Electric-Brain/Smart-Classroom-Automation/Images of Project/IMG4.jpeg

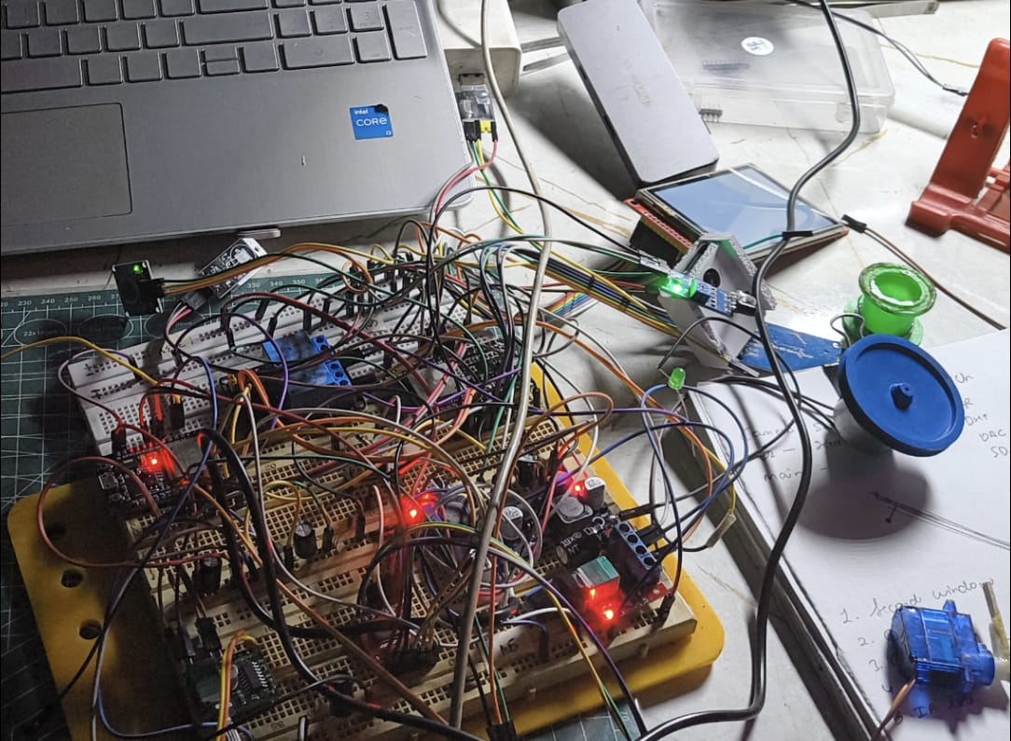
Images of Project/IMG4.jpeg
