Electric-Brain/Smart-Classroom-Automation/Images of Project/IMG1.jpeg

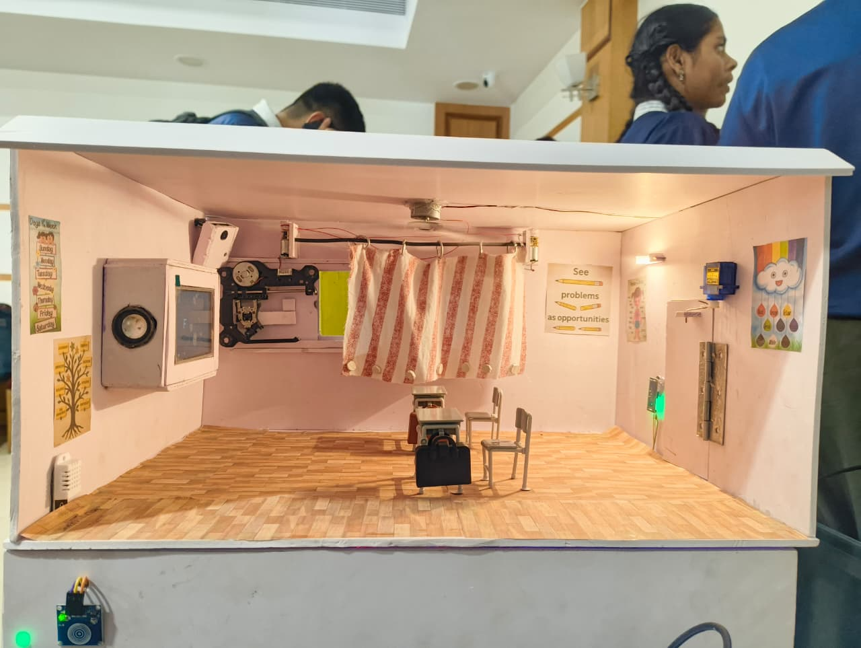
Images of Project/IMG1.jpeg
