Electric-Brain/Smart-Classroom-Automation/Documentation PDF/Autovent_SmartClassroom_Documentation (1).pdf

# AUTOVENT

# A Complete Smart Classroom

IoT-Based Classroom Automation System

Best Depth of Understanding Award — Yashwantrao Chavan Center, Mumbai

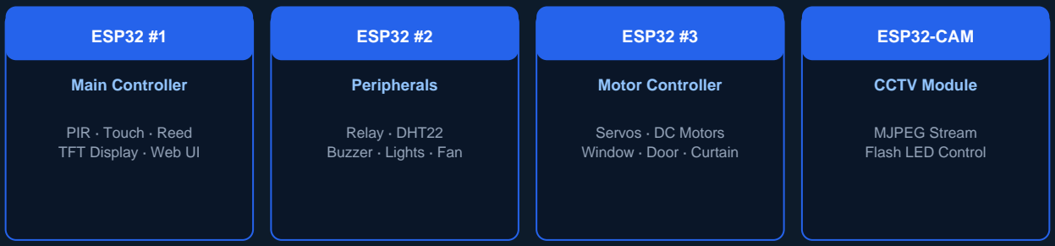
[picture p3: figure]
ESP32 #1; Main Controller; PIR · Touch · Reed TFT Display · Web UI; ESP32 #2; Peripherals; Relay · DHT22 Buzzer · Lights · Fan; ESP32 #3; Motor Controller; Servos · DC Motors Window · Door · Curtain; ESP32-CAM; CCTV Module; MJPEG Stream Flash LED Control

Institution | Thakur College of Engineering & Technology (TCET), Mumbai
Program | TCET Inhouse Internship
Collaboration | Agastya International Foundation
Deployed at | Sanmitra Mandal Vidhyalaya, Goregaon East
Team | Gautam | | Shivangi Vishwakarma
3× ESP32 · ESP32-CAM · | TFT Display | · Servo & DC Motors · WebSocket Dashboard

Technical Documentation — All Rights Reserved

Autovent — Smart Classroom | Technical Documentation

# Table of Contents

1. | Project Overview | 3
2. | System Architecture | 4
3. | Hardware Components — All Boards | 5
4. | Pin Mapping — All Boards | 7
5. | Firmware Modules | 10
6. | UART Communication Protocol | 13
7. | Web Dashboard | 14
8. | Setup & Flashing | 15
9. | Libraries Required | 16
10. | Known Issues & Fixes Applied | 17

# 1. Project Overview

Autovent is a fully integrated IoT-based smart classroom automation system developed as part of the TCET Inhouse Internship program in collaboration with the Agastya International Foundation. It was deployed and demonstrated at Sanmitra Mandal Vidhyalaya, Goregaon East, Mumbai, and received the Best Depth of Understanding Award at the project showcase held at Yashwantrao Chavan Center.

The concept was originated by school students who identified a real operational problem: the school peon was manually responsible for opening and closing windows, curtains, and doors multiple times every school day. Autovent automates this entirely through sensors, microcontrollers, motors, and a real-time web dashboard accessible from any browser on the local network.

## 1.1 Core Capabilities

- Automated door control via PIR motion detection with 5-second auto-close timer
- Motor-controlled Window 1, Window 2, Curtain, and Door (servo + DC motors)
- Relay-controlled classroom lights and ceiling fan with PWM fan speed control
- Live MJPEG video surveillance stream from the ESP32-CAM module
- Real-time temperature and humidity monitoring via DHT22 sensor
- Audio announcements via DFPlayer Mini + 3W speaker on ESP32 #2
- Reed switch close-confirmation with stuck-window detection and alert
- Full web dashboard with WebSocket-based live state synchronisation
- ILI9488 TFT status display showing sensor readings, actuator states, and WiFi info
- Capacitive touch sensor for physical master ON / OFF toggle
- Master switch: single action activates or fully deactivates the entire classroom
- Dual LM2596 buck converters step 12V down for logic and motor supply

## 1.2 Project Metadata

Field | Details
Institution | Thakur College of Engineering and Technology (TCET), Mumbai
Program | TCET Inhouse Internship
Collaboration | Agastya International Foundation
Deployed at | Sanmitra Mandal Vidhyalaya, Goregaon East, Mumbai
Award | Best Depth of Understanding — Yashwantrao Chavan Center Showcase
Team | Gautam, Shivangi Vishwakarma

# 2. System Architecture

The system uses four independent hardware nodes — three ESP32 boards and one ESP32-CAM — communicating over WiFi and UART. ESP32 #1 (Main Controller) acts as the central intelligence: it hosts the web server, processes all sensor inputs (PIR, touch, reed switches), drives the TFT display, and sends commands to both ESP32 #2 and ESP32 #3 over UART. ESP32 #2 handles all electrical peripherals (relays, buzzer, DHT22). ESP32 #3 is a dedicated motor controller. The ESP32-CAM operates fully independently on the WiFi network.

Board | Role | Peripherals | Communi cation
ESP32 #1 Main Controller | Central hub — web server, sensor processing, TFT display | TFT Display (ILI9488), PIR (HC-SR501), Touch (TTP223), Reed Switches ×2 | WiFi: HTTP + W ebSocket UART2 → ESP32 #2 & #3
ESP32 #2 Peripherals Board | Electrical control — relays, sensing, audio, buzzer | Relay ×2 (Lights + Fan), DHT22, Buzzer (NPN TXA), DFPlayer Mini, 3W Speaker | UART2 ← ESP32 #1
ESP32 #3 Motor Controller | Actuator control — all motors | Servo ×2 (Door, Win1), DC Motor ×2 (Win2, Curtain), TB6612 Driver | UART2 ← ESP32 #1
ESP32-CAM CCTV Module | Live video surveillance | OV2640 camera, Flash LED (GPIO4) | WiFi: HTTP :80 + :81 (stan dalone)

## 2.1 UART Communication

ESP32 #1 communicates with both ESP32 #2 and ESP32 #3 over dedicated UART links at 115,200 baud, 8N1. All messages are plain ASCII strings terminated with \n. A 300 ms gap between sequential commands (MOTOR_CMD_GAP_MS) ensures each receiver fully processes one command before the next arrives. ESP32-CAM has no UART connection; its IP and endpoints are embedded in the dashboard via the /api/cam REST call.

# 3. Hardware Components — All Boards

## 3.1 ESP32 #1 — Main Controller

Component | Model / Spec | Notes
Microcontroller | ESP32 DevKit v1 (30-pin) | WiFi host, web server, central logic
TFT Display | ILI9488, 480×320 px, SPI | Live status dashboard; VSPI bus
PIR Sensor | HC-SR501 | Motion detection — triggers door auto-open
Touch Sensor | TTP223 capacitive module | Physical master ON/OFF toggle
Reed Switch ×2 | Normally-open, magnetic | Window close confirmation

■ GPIO 34 and 35 are input-only on the ESP32 (used for Touch and PIR). GPIO 36 and 39 are also input-only and have no internal pull-up — external 10 kΩ resistors to 3.3 V are required for both reed switches.

## 3.2 ESP32 #2 — Peripherals Board (Relay, Lights, Fan, Buzzer, Temp, Audio)

Component | Model / Spec | Notes
Microcontroller | ESP32 DevKit v1 (30-pin) | Receives UART commands from ESP32 #1
Relay Module | 2-channel, 5 V, active-LOW, opto-isolated | Channel 1: Lights | Channel 2: Fan
Temp & Humidity | DHT22 (AM2302), 3.3 V | 10 kΩ pull-up on data line
Active Buzzer | 3.3–5 V active buzzer | Driven via NPN transistor amplification circuit
NPN Transistor | BC547 / 2N2222 | Current amplification for buzzer drive
DFPlayer Mini | MP3 audio module | Plays from microSD card; UART-controlled
Speaker | 3 W, 4–8 Ω passive | Connected to DFPlayer Mini DAC output

## 3.3 ESP32 #3 — Motor Controller

Component | Model / Spec | Notes
Microcontroller | ESP32 DevKit v1 (30-pin) | Receives UART commands from ESP32 #1
Servo Motor — Door | Standard 180° servo (MG996R or sim.) | Anticlockwise rotation; reversed pulse range
Servo Motor — Win1 | Standard 180° servo | Normal pulse direction
DC Motor — Win2 | 5–12 V DC geared motor | Motor B channel on driver; 3 s timeout
DC Motor — Curtain | 5–12 V DC geared motor | Motor A channel on driver; 3 s timeout
Motor Driver | TB6612FNG or L298N dual H-bridge | STBY pin controls enable/standby

## 3.4 ESP32-CAM — CCTV Module

Component | Model / Spec | Notes
Camera Module | AI Thinker ESP32-CAM | OV2640 sensor, 2 MP, onboard PSRAM
Flash LED | White LED on GPIO4 | PWM brightness control (0–255)
Antenna | Onboard PCB antenna | External antenna improves range significantly

## 3.5 Power & Control Modules

Component | Spec | Role
5 V DC Adapter | 5 V, min 2 A | Direct supply to ESP32-CAM only
12 V DC Adapter | 12 V, min 3 A | Main supply — feeds both LM2596 buck converters
LM2596 Buck Converter ×2 | Step-down, adjustable | Buck #1: 12 V → 5 V for ESP32 boards; Buck #2: motor/servo supply
PWM Motor Speed Controller | PWM module | Fan speed control; sits between relay output and fan

■ Always verify LM2596 output voltage with a multimeter before connecting any ESP32 board. Incorrect output voltage will permanently damage the microcontroller.

## 3.6 Passive Components

Component | Value / Spec | Purpose
Resistor | 10 kΩ | Pull-up for Reed Switch GPIO 36 & 39; DHT22 data line
NPN Transistor | BC547 / 2N2222 | Current amplification for buzzer drive circuit on ESP32 #2
Jumper Wires | M-M / M-F | Board-to-board interconnects
Breadboard / PCB | Prototype board | Component mounting and circuit prototyping

# 3.7 Power Architecture

The system uses two separate power supplies to isolate logic and motor loads. The ESP32-CAM is powered directly from a dedicated 5 V adapter to avoid noise from motor switching on its supply rail. All remaining boards and actuators are powered from a 12 V adapter, stepped down by two independent LM2596 buck converters — one for ESP32 logic (set to 5 V) and one for motors and servos (set to the appropriate motor voltage).

Supply | Source | Output | Powers
5 V Adapter | Mains (direct) | 5 V DC | ESP32-CAM (AI Thinker board)
12 V Adapter | Mains (direct) | 12 V DC | Input to both LM2596 buck converters
LM2596 Buck #1 | 12 V Adapter | 5 V (adjusted) | ESP32 #1, ESP32 #2, ESP32 #3 logic supply
LM2596 Buck #2 | 12 V Adapter | Adjusted | DC motors, servo motors, relay coils
PWM Speed Ctrl | Buck #2 / Relay | Variable PWM | Ceiling fan speed regulation

# 4. Pin Mapping — All Boards

## 4.1 ESP32 #1 — Main Controller

Signal | GPIO | Direction | Notes
TFT CS | 15 | OUT | VSPI chip select
TFT DC | 2 | OUT | Data / Command select
TFT RST | 4 | OUT | Display reset
TFT MOSI | 23 | OUT | VSPI MOSI
TFT MISO | 19 | IN | VSPI MISO
TFT SCK | 18 | OUT | VSPI clock
PIR HC-SR501 | 35 | IN | Input-only GPIO; HIGH = motion detected
Touch TTP223 | 34 | IN | Input-only GPIO; HIGH = touched
Reed Switch 1 | 36 | IN | Input-only; external 10 kΩ pull-up to 3.3 V required
Reed Switch 2 | 39 | IN | Input-only; external 10 kΩ pull-up to 3.3 V required
UART2 TX → ESP32 #2 / #3 RX | 17 | OUT | 115,200 baud, 8N1
UART2 RX ← ESP32 #2 / #3 TX | 16 | IN | 115,200 baud, 8N1

■ GPIO 34, 35, 36, 39 are input-only — no PWM, no internal pull-up. Reed switch pins (36, 39) need external 10 kΩ resistors to 3.3 V.

## 4.2 ESP32 #2 — Peripherals Board

Signal | GPIO | Direction | Notes
Relay LIGHT | 32 | OUT | LOW = relay energised (active-LOW opto-isolated)
Relay FAN | 33 | OUT | LOW = relay energised (active-LOW opto-isolated)
DHT22 DATA | 26 | IN | 10 kΩ pull-up to 3.3 V recommended
Buzzer (via NPN TXA) | 5 | OUT | HIGH = buzzer ON; NPN transistor drives coil
DFPlayer Mini TX | 16 | IN | HardwareSerial(1) RX ← DFPlayer TX
DFPlayer Mini RX | 17 | OUT | HardwareSerial(1) TX → DFPlayer RX
UART2 RX ← ESP32 #1 TX | 16 | IN | 115,200 baud, 8N1 — from main controller
UART2 TX → ESP32 #1 RX | 17 | OUT | 115,200 baud, 8N1 — to main controller

■ DFPlayer Mini uses HardwareSerial at 9600 baud. Place a 1 kΩ resistor on the DFPlayer RX line to protect the module input.

## 4.3 ESP32 #3 — Motor Controller

Signal | GPIO | Direction | Notes
Servo Door | 5 | OUT | Reversed pulse: 2400 µs (closed) → 500 µs (open) — anticlockwise
Servo Win1 | 18 | OUT | Normal pulse: 500 µs (open) → 2400 µs (closed)
Motor Driver STBY | 23 | OUT | HIGH = driver active; LOW = standby (saves power)
Motor A PWM (Curtain) | 19 | OUT | LEDC channel, 18 kHz, 10-bit resolution
Motor A IN1 (Curtain) | 21 | OUT | H-bridge direction pin
Motor A IN2 (Curtain) | 22 | OUT | H-bridge direction pin
Motor B PWM (Win2) | 25 | OUT | LEDC channel, 18 kHz, 10-bit resolution
Motor B IN1 (Win2) | 26 | OUT | H-bridge direction pin
Motor B IN2 (Win2) | 27 | OUT | H-bridge direction pin
UART2 RX ← ESP32 #1 TX | 16 | IN | 115,200 baud, 8N1
UART2 TX → ESP32 #1 RX | 17 | OUT | 115,200 baud, 8N1

## 4.4 ESP32-CAM — AI Thinker

Signal | GPIO | Notes
PWDN | 32 | Camera power-down control
XCLK | 0 | 20 MHz clock — uses LEDC channel 0
SIOD (SDA) | 26 | SCCB / I²C data
SIOC (SCL) | 27 | SCCB / I²C clock
D7–D0 (8-bit bus) | 35, 34, 39, 36, 21, 19, 18, 5 | Parallel pixel data bus
VSYNC | 25 | Frame synchronisation signal
HREF | 23 | Line synchronisation signal
PCLK | 22 | Pixel clock
Flash LED | 4 | PWM brightness — must be initialised AFTER esp_camera_init()

■ GPIO4 is shared between the flash LED and the onboard SD card slot on AI Thinker boards. Calling ledcAttach() on GPIO4 before esp_camera_init() causes a LEDC channel conflict that prevents the flash from working. Always initialise the flash LED after the camera.

# 5. Firmware Modules

## 5.1 ESP32_Main.ino — Main Controller (ESP32 #1)

The central brain of the system. Hosts an AsyncWebServer on port 80 with a WebSocket endpoint at /ws. The complete dashboard HTML is served from web_ui_v7.h stored in PROGMEM.

Task / Function | Description
AsyncWebServer + WebSocket | Serves dashboard on port 80; handles all browser commands via WS
TFT Display Update | Double-buffered sprite refresh every 1 s — shows temp, states, IP, alerts
PIR Polling | Rising edge → sends DOOR_OPEN via UART; starts 5 s auto-close timer
Touch Polling | 50 ms debounce on TTP223; calls applyMasterSwitch() on detection
Reed Switch Polling | 5-sample debounce at 50 ms intervals; detects window close confirmation
Motor Command Routing | sendMotorCmd() applies INV_* flags then forwards to ESP32 #3 via UART
REST API | /api/state returns full JSON; /api/cam returns camera stream URL
WiFi Watchdog | Calls WiFi.reconnect() if connection is lost in main loop

### Motor Inversion Flags

If a motor physically moves in the wrong direction due to wiring, software flags in ESP32_Main.ino automatically swap OPEN↔CLOSE in the UART string. State variables always hold logical intent — only the transmitted wire command is flipped. No hardware rewiring is needed.

#define INV_WIN1 | true | // Window 1: open/close physically swapped

#define INV_WIN2 | false | // Window 2: correct direction

#define INV_CURTAIN false | // Curtain: correct direction

#define INV_DOOR | true | // Door: | open/close physically swapped

### PIR Auto-Door Logic

On every rising edge from the PIR sensor, the door is opened via UART and a 5-second countdown timer starts. The timer is reset only on a new rising edge — not while the PIR signal remains HIGH. This guarantees the door always closes 5 seconds after the last detected motion event.

## 5.2 SmartClassroom_Peripheral.ino — Peripherals Board (ESP32 #2)

Dedicated firmware for ESP32 #2. Receives UART commands from ESP32 #1 and controls all electrical peripherals: two relay channels, DHT22 sensor, buzzer, and DFPlayer Mini audio module.

Command Received | Action Taken
LIGHT_ON / LIGHT_OFF | Drives Relay 1 LOW (energise) / HIGH (de-energise)
FAN_ON / FAN_OFF | Drives Relay 2 LOW (energise) / HIGH (de-energise)

Command Received | Action Taken
BEEP / BEEP_ALERT | Triggers single beep or three-beep alert via NPN transistor circuit
TEMP_REQ | Reads DHT22 and responds with TEMP:,HUM:
PLAY: | DFPlayer Mini plays track number n from microSD

■ Relays are active-LOW and opto-isolated. Both relay GPIOs must be driven HIGH on boot to ensure lights and fan initialise in the OFF state. DFPlayer Mini communicates at 9600 baud on HardwareSerial(1); a 1 kΩ series resistor on the RX line protects the module input.

## 5.3 Motor_v3.ino — Motor Controller (ESP32 #3)

Dedicated firmware for ESP32 #3. Listens on UART2 at 115,200 baud and controls two servo motors and two DC motors via an H-bridge driver.

### Anticlockwise Door Servo

The door servo rotates anticlockwise by reversing the PWM pulse width range in attach(). A high minimum value and low maximum causes the servo to sweep in the opposite direction for the same degree command.

// Reversed pulse range → anticlockwise rotation:
servoDoor.attach(SERVO_DOOR_PIN, 2400, 500); // min=2400µs, max=500µs

// Normal pulse range for Window 1:
servoWin1.attach(SERVO_WIN1_PIN, 500, 2400); // min=500µs, max=2400µs

### DC Motor Auto-Timeout

Each DC motor run is automatically stopped after MOTOR_TIMEOUT = 3000 ms. This prevents stall current damage and generates a DONE:<name> response on UART back to ESP32 #1 so the dashboard can update its state.

## 5.4 CAM_v9.ino — ESP32-CAM

Standalone camera firmware running two independent HTTP servers. Exposes three endpoints consumed by the main dashboard.

Endpoint | Port | Description
/stream | 81 | MJPEG live stream paced at ~12 fps (80 ms/frame)
/capture | 80 | Single full-resolution JPEG snapshot
/flash?intensity=N | 80 | Set flash LED brightness; N = 0 (off) to 255 (full)

Key fixes in CAM_v9: fb_count = 1 combined with CAMERA_GRAB_LATEST eliminates the frame-buffer desync freeze that affected earlier versions. Frame pacing at 80 ms per frame prevents WiFi TX buffer overflow. Indoor sensor tuning enables auto white balance (mode 2 = indoor), AEC2, and automatic gain control.

# 6. UART Communication Protocol

All messages are plain ASCII strings terminated with \n (newline). Two UART2 links run at 115,200 baud, 8N1 — one between ESP32 #1 and ESP32 #2 (GPIO17/16), and one between ESP32 #1 and ESP32 #3 (same GPIO numbers on each board). Commands flow from ESP32 #1 to ESP32 #2 and ESP32 #3; status responses flow back to ESP32 #1.

## 6.1 Commands — ESP32 #1 → ESP32 #2 (Peripherals)

Command | Action
LIGHT_ON | Energise Relay 1 — lights ON
LIGHT_OFF | De-energise Relay 1 — lights OFF
FAN_ON | Energise Relay 2 — fan ON (speed set by PWM motor speed controller)
FAN_OFF | De-energise Relay 2 — fan OFF
BEEP | Single short beep via NPN transistor buzzer circuit
BEEP_ALERT | Three-beep alert pattern (stuck-window or critical event)
TEMP_REQ | Request DHT22 reading — ESP32 #2 responds with TEMP/HUM string
PLAY: | Play audio track number n from DFPlayer Mini microSD card

## 6.2 Commands — ESP32 #1 → ESP32 #3 (Motors)

Command | Action | Device
WIN1_OPEN | Open Window 1 | Servo → WIN1_OPEN_DEG (0°)
WIN1_CLOSE | Close Window 1 | Servo → WIN1_CLOSE_DEG (180°)
WIN2_OPEN | Open Window 2 | DC Motor B — forward
WIN2_CLOSE | Close Window 2 | DC Motor B — reverse
WIN1_FORCE_CLOSE | Force close Win1 (stuck recovery) | Servo — same as WIN1_CLOSE
WIN2_FORCE_CLOSE | Force close Win2 (stuck recovery) | DC Motor B — reverse
CURTAIN_OPEN | Open curtain | DC Motor A — forward
CURTAIN_CLOSE | Close curtain | DC Motor A — reverse
DOOR_OPEN | Open door | Servo → DOOR_OPEN_DEG (180°, anticlockwise)
DOOR_CLOSE | Close door | Servo → DOOR_CLOSE_DEG (0°)
ALL_STOP | Emergency stop all motors | Both DC motors off; servos homed

## 6.3 Responses — ESP32 #3 → ESP32 #1

Response | Meaning
OK | Command received and executing
DONE:WIN2 | Window 2 DC motor auto-stopped after 3 s timeout
DONE:CURTAIN | Curtain DC motor auto-stopped after 3 s timeout
ALERT:WIN1_STUCK | Win1 reed not triggered after close — window obstructed
ALERT:WIN2_STUCK | Win2 reed not triggered after close — window obstructed
WIN1_OPENED | Win1 reed switch triggered — open position confirmed
WIN2_OPENED | Win2 reed switch triggered — open position confirmed
READY | ESP32 #3 boot complete, ready to receive commands
ERR:UNKNOWN | Unrecognised command string received

# 7. Web Dashboard

The web dashboard is a single-page application inlined in web_ui_v7.h as a PROGMEM HTML string served by ESP32 #1. It uses vanilla HTML/CSS/JavaScript with no external frameworks at runtime (only a Google Fonts CDN link for typography). Access it by navigating to the IP address shown on the TFT display after boot.

## 7.1 Dashboard Panels

Panel | Contents
Environment | Live temperature (°C) + humidity (%) from DHT22; PIR 5 s countdown
Electrical | Light and fan ON/OFF buttons; live relay status indicators
CCTV Live | MJPEG stream from ESP32-CAM; flash intensity toggle; stream reload
Actuator Control | Per-actuator Open/Close buttons for Win1, Win2, Curtain, Door
Reed Confirmation | Reed switch status bars; stuck-window alert + Force Close button
Motor Status Bar | Last motor command string; ALL STOP emergency button
Master Button | Single button — activates or fully deactivates all classroom systems

## 7.2 REST API Endpoints (ESP32 #1)

Endpoint | Method | Response
/ | GET | Full dashboard HTML from PROGMEM
/api/state | GET | JSON snapshot of all sensor and actuator states
/api/cam | GET | JSON: {stream: , flash: } for ESP32-CAM
/ws | WebSocket | Bidirectional live state — browser sends JSON commands, ESP32 pushes state

## 7.3 WebSocket State JSON

State is broadcast to all connected clients every 2 seconds and on every event change.

{
"light": false, | "fan": false,
"win1": false, | "win2": false,
"curtain": false, "door": false,
"temp": 28.4, | "humidity": 62,
"motor": "IDLE", | "classOn": false,
"pir": false,
"win1Alert": false, "win2Alert": false, "reed1Open": false, "reed2Open": false }

# 8. Setup & Flashing

## 8.1 Prerequisites

- Arduino IDE 2.x or PlatformIO IDE
- ESP32 board package — add to Arduino Board Manager URL: https://raw.githubusercontent.com/espressif/arduino-esp32/gh-pages/package_esp32_index.json
- All libraries listed in Section 9 installed
- TFT_eSPI User_Setup.h configured for ILI9488, 480×320, VSPI pins as listed in Section 4.1

## 8.2 Flash Order & Steps

### Step 1: Configure WiFi credentials

Set WIFI_SSID and WIFI_PASSWORD in ESP32_Main.ino and CAM_v9.ino to match your network.

### Step 2: Flash ESP32-CAM first

Upload CAM_v9.ino. Open Serial Monitor at 115,200 baud. Note the Stream and Flash URLs printed.

### Step 3: Update CAM IP in main firmware

In ESP32_Main.ino set CAM_STREAM_URL and CAM_FLASH_URL to the IP noted in step 2.

### Step 4: Flash ESP32 #3 (Motor Controller)

Upload Motor_v3.ino. Verify READY appears on Serial Monitor after boot.

### Step 5: Flash ESP32 #2 (Peripherals Board)

Upload the peripheral firmware. Verify relays initialise in the OFF state (no click on boot).

### Step 6: Flash ESP32 #1 (Main Controller)

Upload ESP32_Main.ino with web_ui_v7.h in the same folder. The TFT will display the assigned IP after WiFi connects.

### Step 7: Verify motor directions

Test each actuator. If a motor moves in the wrong direction, toggle the corresponding INV_WIN1, INV_WIN2, INV_CURTAIN, or INV_DOOR flag in ESP32_Main.ino and reflash — no hardware rewiring needed.

### Step 8: Verify reed switches

GPIO 36 and 39 require external 10 kΩ resistors to 3.3 V. Test by manually closing each window and confirming the reed bar in the dashboard turns green.

# 9. Libraries Required

## 9.1 ESP32 #1 — Main Controller

Library | Source | Purpose
ESPAsyncWebServer | github.com/me-no-dev/ESPAsyncWebServer | Async HTTP server + WebSocket
AsyncTCP | github.com/me-no-dev/AsyncTCP | Dependency for ESPAsyncWebServer
ArduinoJson | Arduino Library Manager (v7.x) | JSON serialisation for WS state
TFT_eSPI | Arduino Library Manager | ILI9488 TFT display driver

## 9.2 ESP32 #2 — Peripherals Board

Library | Source | Purpose
DHT sensor library | Adafruit — Arduino Library Manager | DHT22 temperature & humidity
Adafruit Unified Sensor | Adafruit — Arduino Library Manager | Dependency for DHT library

## 9.3 ESP32 #3 — Motor Controller

Library | Source | Purpose
ESP32Servo | Arduino Library Manager | Servo control using ESP32 LEDC hardware timers

## 9.4 ESP32-CAM

Library | Source | Purpose
esp_camera | Built into ESP32 Arduino core | OV2640 camera sensor driver
esp_http_server | Built into ESP32 Arduino core | Lightweight HTTP server for stream + control
esp_timer | Built into ESP32 Arduino core | Microsecond frame-pacing timer

# 10. Known Issues & Fixes Applied

The following table documents all significant bugs encountered during development, their root causes, and the exact firmware fixes applied. All fixes are present in the firmware versions provided in this repository.

Issue | Root Cause | Fix Applied
Door stays open after reboot | state.doorOpen initialised as true | Initialise state.doorOpen = false; send DOOR_CLOSE in setup()
PIR door never auto-closes | pirDoorOpenedAt reset every loop iteration while PIR stayed HIGH | Reset timer only on rising edge (new motion event), not while sustained HIGH
Master OFF does not close door | Door excluded from applyMasterSwitch(false) path | DOOR_CLOSE added to both ON and OFF paths; PIR timer cancelled before close
ESP32-CAM stream freezes | fb_count=2 caused frame buffer desync under WiFi load | Set fb_count=1 + CAMERA_GRAB_LATEST; added 80 ms frame pacing
Flash LED non-functional | GPIO4 LEDC channel conflict with camera XCLK init | ledcAttach(FLASH_LED_PIN) moved strictly after esp_camera_init()
Motor commands physically inverted | WIN1 and DOOR motor wiring reversed relative to software expectation | Software flags INV_WIN1=true, INV_DOOR=true swap the UART string in sendMotorCmd()
ESP32-CAM error 112 — port conflict | Two httpd_start() calls colliding on same internal ctrl_port value | Stream server: port 81, ctrl_port 32769. Control server: port 80 with default ctrl_port
Sequential UART commands dropped | ESP32 #3 still processing previous command when next arrived | 300 ms MOTOR_CMD_GAP_MS delay inserted between consecutive UART sends in master switch

Autovent — Smart Classroom · TCET Inhouse Internship · Agastya International Foundation · All Rights Reserved
