Electric-Brain/Smart-Classroom-Automation/Images of Project/IMG2.jpeg

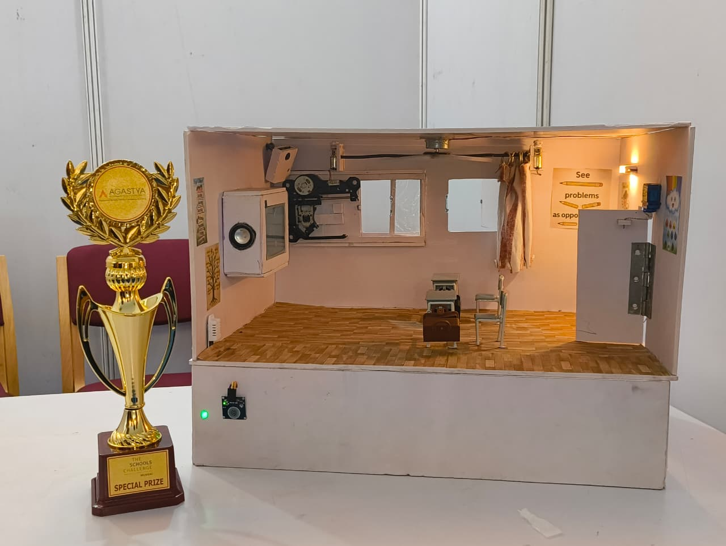
Images of Project/IMG2.jpeg
