Electric-Brain/Smart-Classroom-Automation/Images of Project/IMG3.jpeg

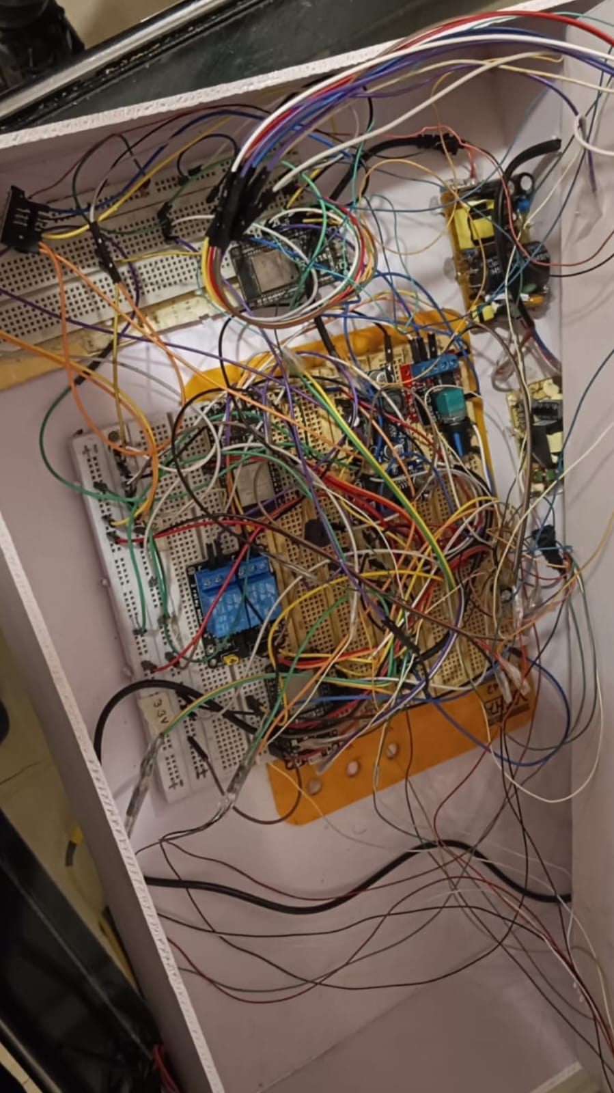
Images of Project/IMG3.jpeg
