Electric-Brain/Smart-Classroom-Automation/Smart-Classroom-Automation/Hardware/Autovent_Hardware_BOM (2).pdf

# AUTOVENT

## Smart Classroom — Hardware Bill of Materials

### Complete component list across all 4 boards · 27 components

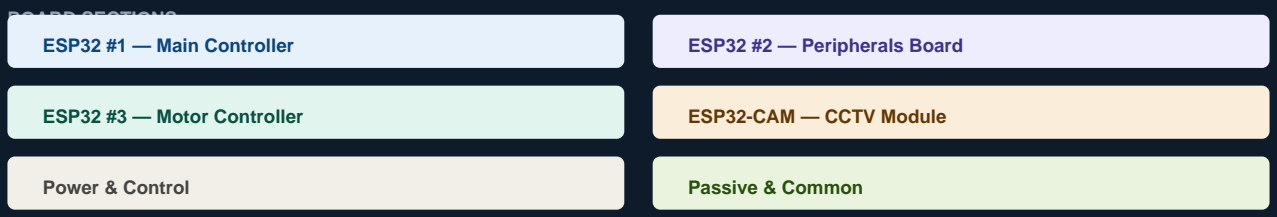
[picture p6: figure]
BOARD SECTIONS; ESP32 #1 — Main Controller; ESP32 #2 — Peripherals Board; ESP32 #3 — Motor Controller; ESP32-CAM — CCTV Module; Power & Control; Passive & Common

Institution | Thakur College of Engineering & Technology (TCET), Mumbai
Program | TCET Inhouse Internship
Collaboration | Agastya International Foundation
Team | Gautam | Shivangi Vishwakarma

Hardware Bill of Materials — All Rights Reserved

TCET Inhouse Internship · Agastya International Foundation

Autovent — Smart Classroom | Hardware Bill of Materials

# Hardware Bill of Materials

Autovent — Smart Classroom · 4 boards · 27 components

Board | Role | Components
ESP32 #1 | Main Controller — TFT, PIR, Touch, Reed | 5
ESP32 #2 | Peripherals — Relay, LED Light, DHT22, Buzzer, DFPlayer Mini | 8
ESP32 #3 | Motor Controller — Servos, DC Motors, 3V Fan Motor, TB6612 | 5
ESP32-CAM | CCTV Module — OV2640, Flash LED | 1
Power | 5V/12V adapters, LM2596 ×2, PWM speed ctrl | 4
Passives | Resistors, transistor, wires, PCB | 4

### ESP32 #1 — Main Controller

# | Component | Model / Spec | Qty | Notes

1 | Microcontroller | ESP32 DevKit v1 (30-pin) | ×1 | WiFi host · web server · central logic
2 | TFT Display | ILI9488, 480×320 px, SPI | ×1 | Live status display; VSPI (CS:15, DC:2, RST:4)
3 | PIR Sensor | HC-SR501 | ×1 | Motion detection → door auto-open; GPIO 35
4 | Touch Sensor | TTP223 capacitive module | ×1 | Master ON/OFF toggle; GPIO 34 (input-only)
5 | Reed Switch | Normally-open, magnetic | ×2 | Window close confirm; GPIO 36 & 39 — needs 10kΩ pull-up

### ESP32 #2 — Peripherals Board (Relay · LED Light · Fan · Buzzer · Temp · Audio)

# | Component | Model / Spec | Qty | Notes

6 | Microcontroller | ESP32 DevKit v1 (30-pin) | ×1 | Receives UART commands from ESP32 #1 at 115,200 baud
7 | LED Light Module | LED module, directly connected | ×1 | Classroom light; controlled via Relay Ch1 (GPIO 32)
8 | Relay Module | 2-ch, 5V, active-LOW, opto-isolated | ×1 | Ch1: LED Light (GPIO 32) · Ch2: Fan (GPIO 33); init HIGH = OFF
9 | DHT22 Sensor | AM2302, 3.3V | ×1 | Temperature & humidity; GPIO 26; 10kΩ pull-up on data line
10 | Active Buzzer | 3.3–5V active buzzer | ×1 | GPIO 5; driven via NPN transistor amplification circuit
11 | NPN Transistor | BC547 / 2N2222 | ×1 | Buzzer current amplification — base resistor + collector to buzzer
12 | DFPlayer Mini | MP3 audio module, microSD | ×1 | GPIO 16/17, HardwareSerial 9600 baud; 1kΩ series on RX line
13 | Speaker | 3W, 4–8Ω passive | ×1 | Connected to DFPlayer Mini DAC output (SPK+ / SPK-)

Autovent — Smart Classroom | Hardware Bill of Materials

### ESP32 #3 — Motor Controller

# | Component | Model / Spec | Qty | Notes

14 | Microcontroller | ESP32 DevKit v1 (30-pin) | ×1 | Receives UART commands from ESP32 #1 at 115,200 baud
15 | Servo Motor | MG996R or similar, 180° | ×2 | Door: reversed pulse (2400–500µs) anticlockwise · Win1: normal (500–2400µs)
16 | DC Geared Motor | 5–12V DC geared motor | ×2 | Win2 (Motor B) · Curtain (Motor A); 3s auto-timeout on stall
17 | DC Motor — Fan | 3V DC small fan motor | ×1 | Separate small fan motor; speed controlled via PWM speed controller
18 | Motor Driver | TB6612FNG dual H-bridge module | ×1 | STBY: GPIO 23; PWMA: 19 (18kHz 10-bit) · PWMB: 25 (18kHz 10-bit)

### ESP32-CAM — CCTV Module

# | Component | Model / Spec | Qty | Notes

19 | AI Thinker ESP32-CAM | OV2640, 2MP, onboard PSRAM | ×1 | Stream :81/stream · Capture :80/capture · Flash :80/flash?intensity=N

### Power & Control Modules

# | Component | Model / Spec | Qty | Notes

20 | 5V DC Adapter | 5V, min 2A | ×1 | Direct supply to ESP32-CAM only — isolated from motor switching noise
21 | 12V DC Adapter | 12V, min 3A | ×1 | Main supply; feeds both LM2596 buck converters
22 | LM2596 Buck Converter | Step-down, adjustable output | ×2 | Buck #1 → 5V for ESP32 boards · Buck #2 → motor/servo voltage supply
23 | PWM Speed Controller | PWM fan speed control module | ×1 | Fan speed regulation; between Relay Ch2 output and ceiling fan

### Passive & Common Components

# | Component | Value / Spec | Qty | Notes

24 | Resistor | 10kΩ, 1/4W | ×3 | Pull-up: Reed GPIO36 (×1) · Reed GPIO39 (×1) · DHT22 data line (×1)
25 | Resistor | 1kΩ, 1/4W | ×1 | DFPlayer Mini RX line protection on ESP32 #2
26 | Jumper Wires | M-M / M-F | — | Board-to-board and sensor interconnects
27 | Breadboard | Prototype board | — | Component mounting and circuit assembly

■ Always verify LM2596 output voltage with a multimeter before connecting any ESP32 board. GPIO 36 and 39 are input-only with no internal pull-up — external 10kΩ resistors to 3.3V are mandatory for reed switches.

Autovent — Smart Classroom · TCET Inhouse Internship · Agastya International Foundation · All Rights Reserved
